TTeuber/AirMidi/docs/daw.md

# The desktop DAW (design, 2026-10-26)

The tracks page grows into a small DAW that does only MIDI: no audio, no plugins. It drives hardware synths and drum
machines (the box's synth, a drum machine over USB, Logic as one more destination). A linear arrangement comes first;
a clip launcher later, over the same clips (see "Later").

What it starts from (docs/desktop.md D3, D4): one transport, step tracks and clip tracks, events planned 120 ms ahead
and sent on time by the engine (`desktop/tracks/sequencer.dart`, `player.dart`), MIDI clock out, recording from any
input with MPE kept. Nothing is saved yet, so the model below replaces the current one without a migration.

## Two kinds of clip, two editors

The user's ask: MIDI clips and pattern clips. Double-clicking a MIDI clip opens a piano roll; double-clicking a
pattern clip opens a step sequencer.

- **MIDI clip:** notes in free time, recorded or drawn, with controller lanes. For synth parts, played lines,
  anything with feel. Edited in the **piano roll**.
- **Pattern clip:** a grid of rows (notes) by steps, the way a drum machine thinks. For beats, bass lines and
  arpeggios that are built step by step. Edited in the **sequencer**.

Any track can hold both kinds. The track says where the MIDI goes; the clip says what plays. A drum machine's track
can then have patterns for the groove and a recorded MIDI clip for a fill, and a synth's track can have a pattern
bass line under a played chorus.

A pattern clip can be turned into a MIDI clip ("to MIDI clip": the steps become notes, so they can get feel or a
fill). There is no way back: a free-time clip does not fit a grid without losing what made it free.

## The window

```
+-------------------------------------------------------------------------------------------+
| transport:  play stop rec  loop  | 120.0 bpm  4/4 | 3.2.1 | clock to: [drums] [box]       |
+----------------+--------------------------------------------------------------------------+
| track headers  | 1        2        3        4        5        6        7     (bars)       |
|                |   [=====loop range=====]                     |playhead                    |
| drums      M S | [pat A ][pat A ][pat B ][pat A ][fill~~]                                   |
|  TR-8 ch10   o | ^ pattern clips                     ^ a MIDI clip on the same track       |
| bass       M S | [pat 1 ................ ][pat 2 ......]                                    |
|  box synth ch1 |                                                                          |
| keys       M S |          [~~~~ take 1 ~~~~~~~~~~~~~~][~~~ take 2 ~~~]                      |
|  Logic ch3   o |                                                                          |
+----------------+--------------------------------------------------------------------------+
| bottom panel: the open clip's editor (piano roll or sequencer)  |  tabs: editor | device    |
|                                                                                           |
+-------------------------------------------------------------------------------------------+
```

- **Arrangement** at the top: tracks down, time across, a bar ruler, the loop range, the playhead. Zoom with
  pinch or cmd-scroll; positions snap to bars, beats or off.
- **Bottom panel**, as in Logic and Ableton: the clip being edited, in its editor. A drag on the divider sizes it.
  The **device** tab is the play view's synth controls (`SynthControls`) for the selected track's MIDI-CI device,
  so the sound can be changed next to the part.
- **Track header:** name and colour, the device (port, channel or MPE zone, the MIDI-CI device behind it if there
  is one), mute, solo, record arm with its input, and monitor (what is played goes through to the device while
  armed, as now).

### Clips on the arrangement

- Draw an empty clip (choose MIDI or pattern), or record one.
- Move, and copy with alt-drag or cmd-D (duplicate after itself). Split at the playhead, delete, copy and paste.
- The right edge sets the clip's length on the timeline. If that is longer than the content, the content loops (a
  one-bar pattern dragged to eight bars plays eight times); shorter cuts it. The left edge trims the start.
- A note still sounding where a clip ends gets its note off there, so cut clips never leave hanging notes.

## The piano roll (MIDI clips)

- Keys down the left with note names; on a drum device, the drum names from its map. Clicking a key plays it on the
  track's device.
- Notes as bars. Draw, select (click, drag a box, cmd-A), move, resize, delete. Alt-drag copies. Arrows move a
  semitone or a grid step; shift-arrows an octave or a bar.
- Grid and snap: 1/4 to 1/32 with triplets, or off. Quantize the selection (start, optionally ends, with a
  strength), transpose, legato, and set or scale velocity.
- **Velocity lane** under the notes: a stalk per note, dragged.
- **Controller lanes:** one per controller in the clip, added from a list. For a MIDI-CI device that list is its
  own controls by name ("Cutoff", "Env Amt", their ranges and named points from the control list) instead of CC
  numbers. Pitch bend, channel pressure, and program change get their own lanes. A lane is breakpoints: steps, or
  ramps that play as a stream of values.
- **MPE:** each note's own bend, pressure and timbre (CC74) are drawn along the note (bend as a line through the
  bar, as the clip painter does now) and can be edited by opening the note's expression.
- Recording into the open clip: overdub (adds, the default) or replace, over the loop range.

## The sequencer (pattern clips)

- Rows by steps. A click toggles a step. A drag up or down on a step sets its velocity, shown as the fill height.
- **Rows** come from a row set:
  - a drum map (General MIDI by default, or the device's own names);
  - a scale (key, scale and octaves, so a bass line only offers notes in key);
  - chromatic (an octave from a chosen note).

  Rows can be added, removed, muted and renamed.
- **Length** 1 to 64 steps, shown in pages of 16, and a step size (1/16 by default, 1/8, 1/32, triplets). Swing
  per pattern.
- **Per step:** velocity, gate (length), probability, nudge (a little early or late), and repeat (ratchets: 2 to 4
  hits in the step). The lane under the grid edits the chosen one for every step in a row, like the piano roll's
  velocity lane.
- **Per row length (later):** rows of different lengths drift against each other, the polymeter the step tracks
  have now per track.
- **Parameter locks:** a step can also set a control of the device (the filter opens on step 7 only).
  MIDI-CI names make these readable. It is what makes a step sequencer play a hardware synth well. A lock lasts one
  step: the steps without one send the track's own value (its synth's saved setting, or the list's default).

### Every clip is its own

Every clip, pattern or MIDI, owns its content (user decision 2026-10-26). Duplicating a clip copies it, and a copy
can go to another track (drag it onto that track, or copy and paste), so a drum pattern can be tried on a second
drum machine. Editing one clip never changes another.

## Model

Pure Dart, no Flutter imports, tested like `sequencer.dart` now.

```
Project
  tempo (bpm; tempo changes later), time signature (one; changes later), loop range (times in beats)
  tracks: [Track]
Track
  name, colour, mute, solo
  device: port name, channel (0-15) or MPE zone (manager channel + member count), MIDI-CI device id (optional)
  input (for recording), arm, monitor
  clips: [Clip]                       placements on the timeline
Clip
  start, length (beats on the timeline), offset (where in the content it starts), loops: bool
  content: MidiContent | Pattern      owned by the clip; a copy copies it
MidiContent
  length (beats, the loop length), notes: [Note], lanes: {controller: [Point]}, other: [raw events]
Note
  start, length, pitch, velocity, release velocity, expression: {bend|pressure|timbre: [Point]} (MPE)
Pattern
  rows: [Row(note, name, mute)], steps, step size, swing, cells[row][step]: Step(velocity, gate, prob, nudge, repeat)
```

- **Times** in beats (doubles) everywhere, as now: no ppq rounding inside, so recorded timing is kept exactly. SMF
  export rounds to its ppq.
- **Values** are stored at MIDI 2.0 resolution (16-bit velocity, 32-bit controllers; the MIDI-CI controls already
  are 32-bit) and scaled down for MIDI 1.0 ports. The model does not have to change when MIDI 2.0 ports arrive.
- **Recording turns raw messages into notes and lanes.** That is a change from the current clips, which keep the
  raw bytes. It is needed for editing: a note has to be one thing that moves with its own bend. Messages that are
  neither notes nor controllers (SysEx, for instance) stay raw in `other`.
- **MPE without fixed channels.** An MPE recording stores notes with their expression, not the member channel each
  was played on. Playback hands out member channels afresh (least recently used, as the strips' player does). Copied
  or moved notes then never collide on a channel. On a track that is not MPE, notes go out on the track's channel
  and per-note bends are dropped (with a warning on the track).
- **Undo:** every edit is a command (do / undo) on the project. One stack per project, cmd-Z / shift-cmd-Z. A drag
  is one command, not one per frame.

## Playback

The arrangement compiles into events window by window, as `eventsBetween` does now. Every 20 ms, for the next
120 ms, each track asks the clips that overlap the window for their events (notes cut at the clip's end, pattern
steps with swing, nudge and probability), plus clock.

- **Edits during play** take effect from the next window: at most 120 ms of already planned events play the old
  way. This is simpler and safer than pulling back events already handed to the engine, which risks lost note offs.
- **Probability** is rolled when a window is planned, with a seed per pass, so a loop does not repeat the same
  "random" choices every time unless that is asked for.
- **Starting in the middle:** the last value of each controller before the start position is sent first
  (controller chase, on by default). This matters for hardware: the filter is where the song says, not where it was
  left. Notes that began before the start are not started (note chase off, as in most DAWs; an option later).
- **Clock** out per port as now; follow Logic later (docs/desktop.md D5).
- **Latency offset per port** (ms, positive or negative): a synth over BLE and a drum machine over USB answer at
  different delays, so each port's events move by its offset. Kept for the computer, not the song (the same synth
  answers as late in every project). Set by hand for now; a calibration tool with a loopback later.

## Recording

- Arm a track (or several), press record. Each armed track gets a new MIDI clip from where recording started to
  where it stopped, from its input, at the engine's timestamps, as now.
- **Loop recording:** each pass adds to the clip (overdub), as now. Takes (each pass its own clip, pick the best)
  come later.
- **Count-in** of a bar, and an optional **MIDI click**: a note on a chosen port and channel (a drum machine's rim
  shot), since there is no audio for a metronome.
- **Input latency:** the input's own offset (BLE input arrives a few ms late) is taken off the timestamps.
- Recording into a pattern (step entry while stopped, or live into the steps it lands nearest) comes after the
  sequencer itself.

## Projects and files

- One project is one JSON file (`.airmidi`, readable, with a format version), saved where the user picks
  (the default is `~/Music/airmidi`). Autosave and a recent-projects list. The sandbox needs the
  user-selected-files entitlement.
- **Standard MIDI File** export: type 1, a track per track, patterns rendered to notes. Import: each SMF track
  becomes a track with one MIDI clip.
- **Device state with the project:** a MIDI-CI device reports its current values (the MIDI Message Report
  the synth page already asks for). The project keeps them per track and sends them back when it opens and when
  play starts, so the box's synth sounds the same next time. For other hardware: program change and bank select
  per track, sent the same way, first.

## Phases

- **A1, the arrangement:** the model above, tracks with headers, clips of both kinds placed, moved, resized
  (looping), duplicated, split, deleted, zoom, snap, loop range, playhead, undo. The current step tracks and clip
  tracks become a pattern clip and a MIDI clip. Plays through the existing scheduler.
- **A2, the piano roll:** notes, the velocity lane, snap, quantize, transpose, audition, recording into the clip
  (raw recordings turned into notes, MPE included).
- **A3, the sequencer:** the grid, row sets, length and step size, swing, the per-step lane (velocity, gate,
  probability, nudge, repeat), "to MIDI clip".
- **A4, files:** save, open, autosave, recent projects, SMF export and import.
- **A5, controllers:** controller lanes with MIDI-CI names, MPE expression editing, controller chase, the device
  tab.
- **A6, hardware:** program change per track, device state with the project, MIDI click and count-in, latency
  offsets per port, parameter locks.
- **Later:** the clip launcher (a grid of the same clips by scene; the clips' contents are already separate from
  where they sit on the timeline), tempo and time signature changes, takes, track automation over the whole song,
  follow Logic, MIDI 2.0 ports, row lengths per pattern row, mono 303-style patterns (a note, slide and accent per
  step).

Tests as now: the model and the compiler in Dart unit tests (windows join without gaps or doubles, clip ends cut
notes, loops, swing, chase, undo), timing through a mido port, the pages driven with `tool/drive.py`.

## Status

- **A1 (2026-10-26):** `app/lib/desktop/daw/`. `model.dart` (the model above; MIDI 2.0 values with M2-115
  scaling), `compile.dart` (clips to timed events: passes through looping content, notes cut at the clip's end and
  at each pass, the loop's end; patterns with swing, nudge, repeats and probability rolled from the step's identity;
  MPE notes on member channels handed out afresh, each starting from its own bend), `record.dart` (takes: raw input
  rebuilt into notes and lanes every tick, overdub in the loop range or a clip that grows by bars; MPE kept per note,
  detected at three note channels), `history.dart` (undo by snapshot), `player.dart` (the scheduler of D3 over a
  continuous beat count mapped into the loop; clock follows the continuous count; Song Position and Start or
  Continue), `arrange_page.dart` + `timeline.dart` (transport, headers with port, channel, MPE, input, M/S/R;
  ruler: click = start marker, drag = loop range; clips: move across tracks, resize both edges, alt-drag copy,
  right-click menu with rename, duplicate, split, copy, delete; empty space: new MIDI or pattern clip, paste;
  zoom and scroll by trackpad or cmd-scroll; keys: space, R, L, cmd-Z, delete, cmd-D/C/V/T), the bottom panel
  (`pattern_editor.dart`: toggle steps, length, step size, swing, row sets; `piano_roll.dart`: shows the notes and
  each note's bend). Tracks can send to "airmidi app" (to Logic) and record from it. Tests (`test/daw_test.dart`):
  value scaling, clip passes and offsets, windows joining for 20 random splits, swing, repeats, probability,
  MPE channels and bends, solo, the loop cut, takes in a loop, growing takes, an MPE take, undo. Tried in the app
  through mido ports at 120 bpm: a beat and its duplicate with snares added only to the copy (every note on time to
  0.2 ms, the original unchanged), a one-bar loop repeating without a gap, a two-note take recorded from "airmidi
  app" (passed through while recording, then played back exactly 2000 ms later each pass), undo and redo of the
  take, moving it a bar and onto another track, clock (20.83 ms ticks, Start, Stop), split at the start marker.
  The old step and clip tracks (`desktop/tracks*`) are gone. Not tried: alt-drag (the drive hook cannot hold alt).

- **A2 (2026-10-27):** the piano roll edits (`piano_roll.dart`, the edits as functions in `roll_edit.dart`). Draw
  (double-click, or click in draw mode, B; a drag sets the length), select (click, shift-click, box, cmd-A, Esc),
  move (snapped, pitch by row, the group kept inside 0..127 and after beat 0), alt-drag copies, resize the end or the
  start, delete (double-click or right-click a note, delete key); arrows move a semitone or a grid step (shift: an
  octave or a bar); cmd-C / V (at the start marker inside the clip) / D (after itself); grids 1/4 to 1/32, 1/8T,
  1/16T, off; quantize (Q, strength 25-100 %, ends optional; lengths kept otherwise), legato (chords stay chords),
  transpose and octave, velocity up and down, all on the selection or every note when none is selected; the velocity
  lane (drag a stalk, a selected group moves together, or sweep across). Keys down the left are a keyboard (drum
  names on a channel 10 track); clicking one plays it on the track's device, and so does a note being drawn, moved
  or transposed. Keys go to the roll after a click in the bottom panel (its delete removes notes, not the clip).
  Recording: overdub or replace (the take in the loop range starts from an empty clip; undo brings the old notes
  back). Tests (`test/roll_test.dart`): the edit functions, replace, and the widget driven by the mouse (draw, move,
  delete, resize, box select, the velocity lane on a group). Tried in the app through the IAC bus: four notes drawn
  played back exactly on their beats and sixteenths; box select, cmd-A, the up arrow, cmd-Z, backspace, a lowered
  velocity (21 out), a key click auditioned, alt-drag copied a note a beat and a half later. The drive tool gained
  `drag`, `rtap` (right click) and the keys space, backspace, escape, the arrows and meta / shift / alt.

- **A3 (2026-10-27):** the sequencer (`pattern_editor.dart`, one canvas for the grid and labels, one for the lane).
  A click adds a step and plays it, a drag paints along (every cell between two pointer events, so a fast drag
  skips none); a click on a step removes it, up/down sets its velocity (the fill's height), sideways erases along.
  The lane under the grid edits the selected row's velocity, gate (0.05-2 steps), probability, nudge (+-half a
  step) or repeat (1-4), by dragging or sweeping, double-click for the default; steps show their chance (a dot),
  repeats (ticks) and nudge (a mark). Rows: GM 6 or 12 rows, or a scale (key, eight scales including chromatic, from
  an octave, one or two octaves); + row (the GM drums not there yet, or a semitone above); a label's M mutes, a
  click selects it for the lane, a right-click renames, moves the note, moves or removes the row. Length 1-64 with
  "double" (the second half a copy), step sizes 1/8, 1/16, 1/32, 1/8T, 1/16T, swing, shift (rotate) left/right, pages
  of 16 when the steps are too narrow, following the playhead. "to MIDI clip" (panel and clip menu):
  `patternHits` is now what both playback and the conversion read, so the MIDI clip plays exactly what the pattern's
  first pass played (probabilities rolled the same; a step nudged before the start wraps to the end). The piano roll
  opens centred on the clip's notes and has a wider key column with drum names on a channel 10 track. Tests
  (`test/pattern_test.dart`): conversion = playback, the wrap, scales, rotate, double, the widget (add and audition,
  a fast paint, sideways erase, remove, undo, velocity by drag, the lane, pages). Tried in the app through mido: a
  beat of kick, snare and painted hats with a velocity sweep (112 down to 10 out) and a 4x repeat (31.25 ms apart),
  then "to MIDI clip": the bar's 50 events identical before and after.

- **A4 (2026-10-27):** files. `project_file.dart`: one JSON file per project (`.airmidi`, "format": "airmidi
  project", version 1; values as kept, step settings only where they differ from the defaults; clip ids kept, so
  probabilities roll the same after reopening; a newer or foreign file is refused). `store.dart`: the project is
  written again every 3 s when it changed (atomically, through a temporary file), so there is no save to forget; an
  untitled project goes to an autosave file in the app's folder; the last project opens again at start; up to 8
  recent ones. `smf.dart`: export type 1 at 480 ticks a beat through the same compiler that plays, so a file holds
  what play sends (patterns rendered, MPE on member channels after an MPE Configuration Message); import type 0/1
  (running status, SysEx skipped, SMPTE refused), a track per channel, or one MPE track when the file sends an MPE
  setup or plays notes on three channels or more (the setup is not kept: played again at a clip's start it would cut
  the synth's notes); one clip per track in whole bars; an empty project takes the file's tempo. The arrangement's
  "file" menu: new, open, recent, save as, import, export; cmd-S writes now, shift-cmd-S saves as, cmd-O opens.
  macOS: file_selector (the Flutter team's, BSD) for the dialogs, the user-selected files and music folder
  entitlements; ~/Music/airmidi is the default folder (the sandbox's Music is the user's own). Recent projects
  outside ~/Music cannot be reopened without the dialog (no security-scoped bookmarks yet). Tests
  (`test/files_test.dart`): a song with one of everything reads back to the same file and the same MIDI, refusals,
  the export's header, tempo and MPE setup, export then import plays the same ticks, a hand-made type 0 file with
  running status, the store (autosave, save as, reopen at start, recent). Tried in the app: a beat autosaved to the
  container, the app restarted with the beat back, ~/Music/airmidi made, the save dialog opening there. Not tried in
  the app: picking a file in the open or save dialogs (the terminal cannot click in them).

- **A5 (2026-10-27):** controllers. A track can hold its synth's MIDI-CI control list (`devices.dart`; the track
  header's menu, "synth controls from ...": a box the desktop has found, over Wi-Fi or BLE, `/api/ci/device`, or a
  JSON file; saved with the project). The piano roll's lane row (`lanes.dart`): velocity, the clip's controller lanes
  named by the synth ("Cutoff" for CC 74, its readings in Hz or ms while dragging) or by General MIDI, "+ lane" (the
  synth's controls first, then common ones it does not name, any CC, bend, pressure, program), and on an MPE track
  the selected note's own bend, pressure and timbre (points from the note's start). Points: click adds, drag moves,
  double-click makes it ramp to the next, right-click removes, draw mode draws along a drag; a ramp plays as a
  stream (a value every 1/64 beat at most, only when the message changes; `laneValues`, the same however the windows
  fall). Controller chase (`chase` in compile.dart, the transport's "chase", on by default): the last value of every
  controller, bend, pressure and program before the start goes out just before the first beat, and again where the
  loop starts over; MPE notes' own expression is not chased. The bottom panel's "device" tab: the play view's
  SynthControls for the selected track's list, sending through the track's port and following the input of the
  same name (not the app's own port, whose other side is the app itself). Tests: ramps (stream, windows), chase,
  the lane editor (add, drag, ramp, remove), an MPE note's bend edited and played on its channel, lists and ramps
  saved. Tried in the app with the box on Wi-Fi and daisy_synth on its TRS: the list fetched ("Daisy Poly Synth, 19
  controls"), the device tab with daisy's envelopes and XY pad, a Vibrato drag sending CC 1 rising 4 to 49, the "+
  lane" menu with daisy's names, a Cutoff ramp 12 to 115 over two beats (a value every 7-16 ms) restarting with the
  loop, the chase sending Cutoff 115 before a start at beat 4 (and nothing with chase off). Not tried: the last hop
  to daisy through the box from the DAW (it needs the box as a CoreMIDI port: its network session connected in
  Audio MIDI Setup, or BLE MIDI); the box's own "current values" report is not asked (values start at the list's
  defaults; device state is A6). Fixed on the way: menu chips ("rows", "+ row", "+ lane") never opened their menus
  (an inner tap detector won the gesture).

- **A6 (2026-10-27):** hardware. Program change and bank select per track (the header's menu, "program and bank":
  program 1-128, MSB, LSB, blank fields not sent). The synth's settings with the project (`Track.state`, lane keys
  at 32 bit): what the device tab sets and what the synth's knobs send back is kept on the track, and "read from the
  synth" asks the box for a MIDI Message Report (the box the list came from, or another; the synth's answer comes
  over the box's own link, its Wi-Fi web socket or BLE MIDI) and keeps every value. Bank, program and settings go
  out when a project opens (and the app starts with it), when play starts (before the chase, so the song's lanes win)
  and on "send to the synth"; MIDI file export writes them at the start of each track. They are not undone (they are
  where the knobs are): after undo the synths' values go back onto the restored tracks. The click (transport:
  a port, note and channel, General MIDI side stick on channel 10 by default, the bar's first beat louder) and the
  count-in (off, 1 or 2 bars, when recording from stopped; the click plays in it even when off; the position shows
  "count n"). Latency per port (transport, "latency": outputs and inputs, -100 to 100 ms, kept in the app's
  settings): an output's events go out that much early (the lookahead and the start grow by the largest), an input's
  timestamps are taken back by it. Parameter locks in the sequencer ("+ lock": the synth's controls first, then
  the common ones; a step's bar is its lock, double-click or right-click takes it off; the line across the lane is
  the track's own value, and a step with locks has a mark in its corner): every group of steps that play together
  sends each locked controller, the first locked step's value (by row) or the own value, so a lock lasts one step
  and a step that does not play leaves nothing behind; with no own value a lock lasts to the next. "to MIDI clip"
  turns the locks into lane points that play the same. Tests (`test/hardware_test.dart`, `pattern_test.dart`): the
  setup's order and channels, locks (one step, the locked step winning at the same time, no own value, the list's
  default, windows joining, to MIDI clip, chase), files, export, the player with a fake engine (count-in with the
  click, the click on, an output's offset), the lock lane driven by the mouse. Tried in the app with the box on its
  RTP session and daisy_synth on its TRS: program 5 / bank 1, 2 sent on play (CC 0, CC 32, program 4); the count-in
  bar of four clicks 545.4 ms apart at 110 bpm, the first louder, then the song's; daisy's cutoff set to CC 74 = 100
  from outside the app and read back through the box ("19 values read from the synth (ok)", cutoff 4.7 kHz), all
  19 kept in the project; "send to the synth" 22 messages into the box's RTP port and out of its TRS; a pattern with
  step 9's cutoff locked at 110 Hz playing CC 74 = 32 before that step and 100 (the own value) before the others,
  to the IAC bus and through the box to daisy (36 messages in, 88 bytes out on TRS); an IAC offset of +20 ms moving
  its notes 19.9 ms ahead of the click on another port; a Vibrato drag kept as the track's setting. Not tried: BLE
  for "read from the synth", input offsets (no loopback in this setup), program changes heard on a synth that has
  programs (daisy has none). Seen on the way: something else on this Mac (not the DAW: a plain script does the same)
  repeats bank select on the IAC bus. The drive tool gained digits and `text` (a text field's text, through a new
  debug hook command).

## Decided (2026-10-26, the user)

1. Every clip is its own (no shared patterns); clips copy to other tracks.
2. Both clip kinds on any track.
3. The editor in the bottom panel.
4. MPE replayed on fresh member channels.
5. Parameter locks later (they came in A6).
