TTeuber/AirMidi/hardware/pcb/board_3d_bottom.png

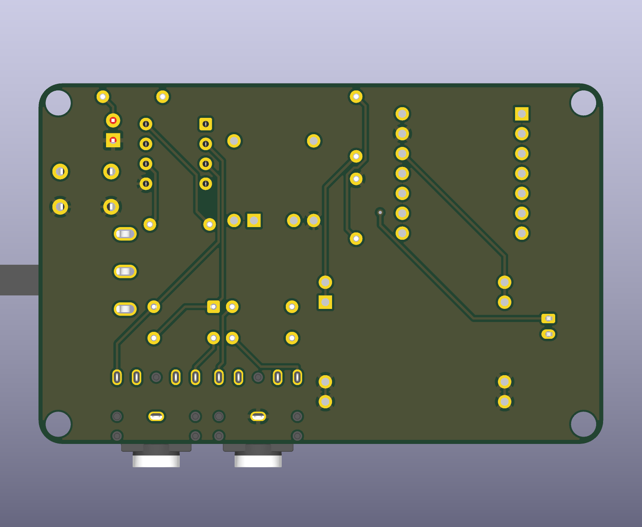
hardware/pcb/board_3d_bottom.png
