TTeuber/AirMidi/hardware/enclosure/base.step

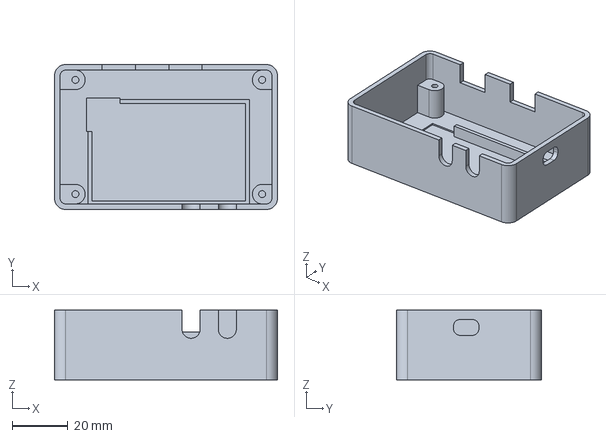
[picture p13: CAD file, 2026-10-10]
hardware/enclosure/base.step
80.0 x 52.0 x 25.1 mm
