TTeuber/AirMidi/hardware/enclosure/lid.step

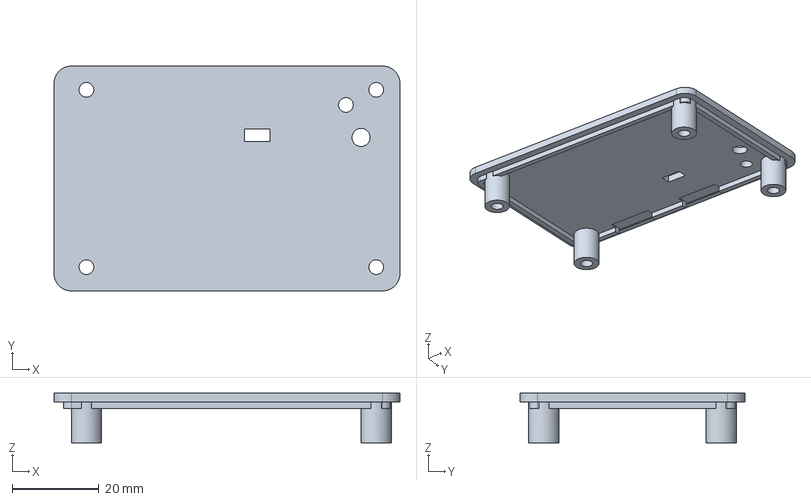
[picture p14: CAD file, 2026-10-10]
hardware/enclosure/lid.step
80.0 x 52.0 x 11.5 mm
