TTeuber/AirMidi/(list of files, cad)

Other CAD files:
hardware/enclosure/base.stl
hardware/enclosure/lid.stl
