TTeuber/AirMidi/hardware/enclosure/assembly_views.png

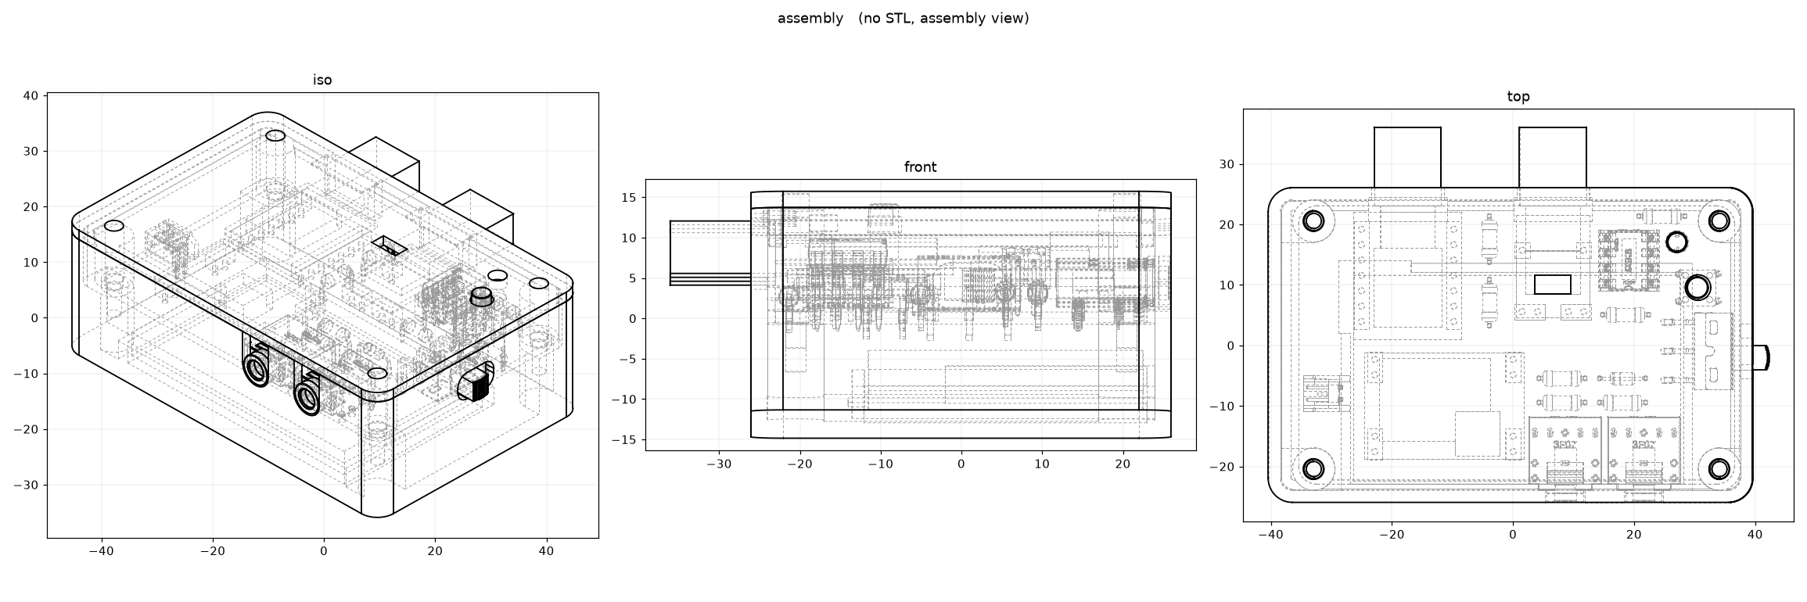
hardware/enclosure/assembly_views.png
