TTeuber/AirMidi/hardware/pcb/schematic.pdf

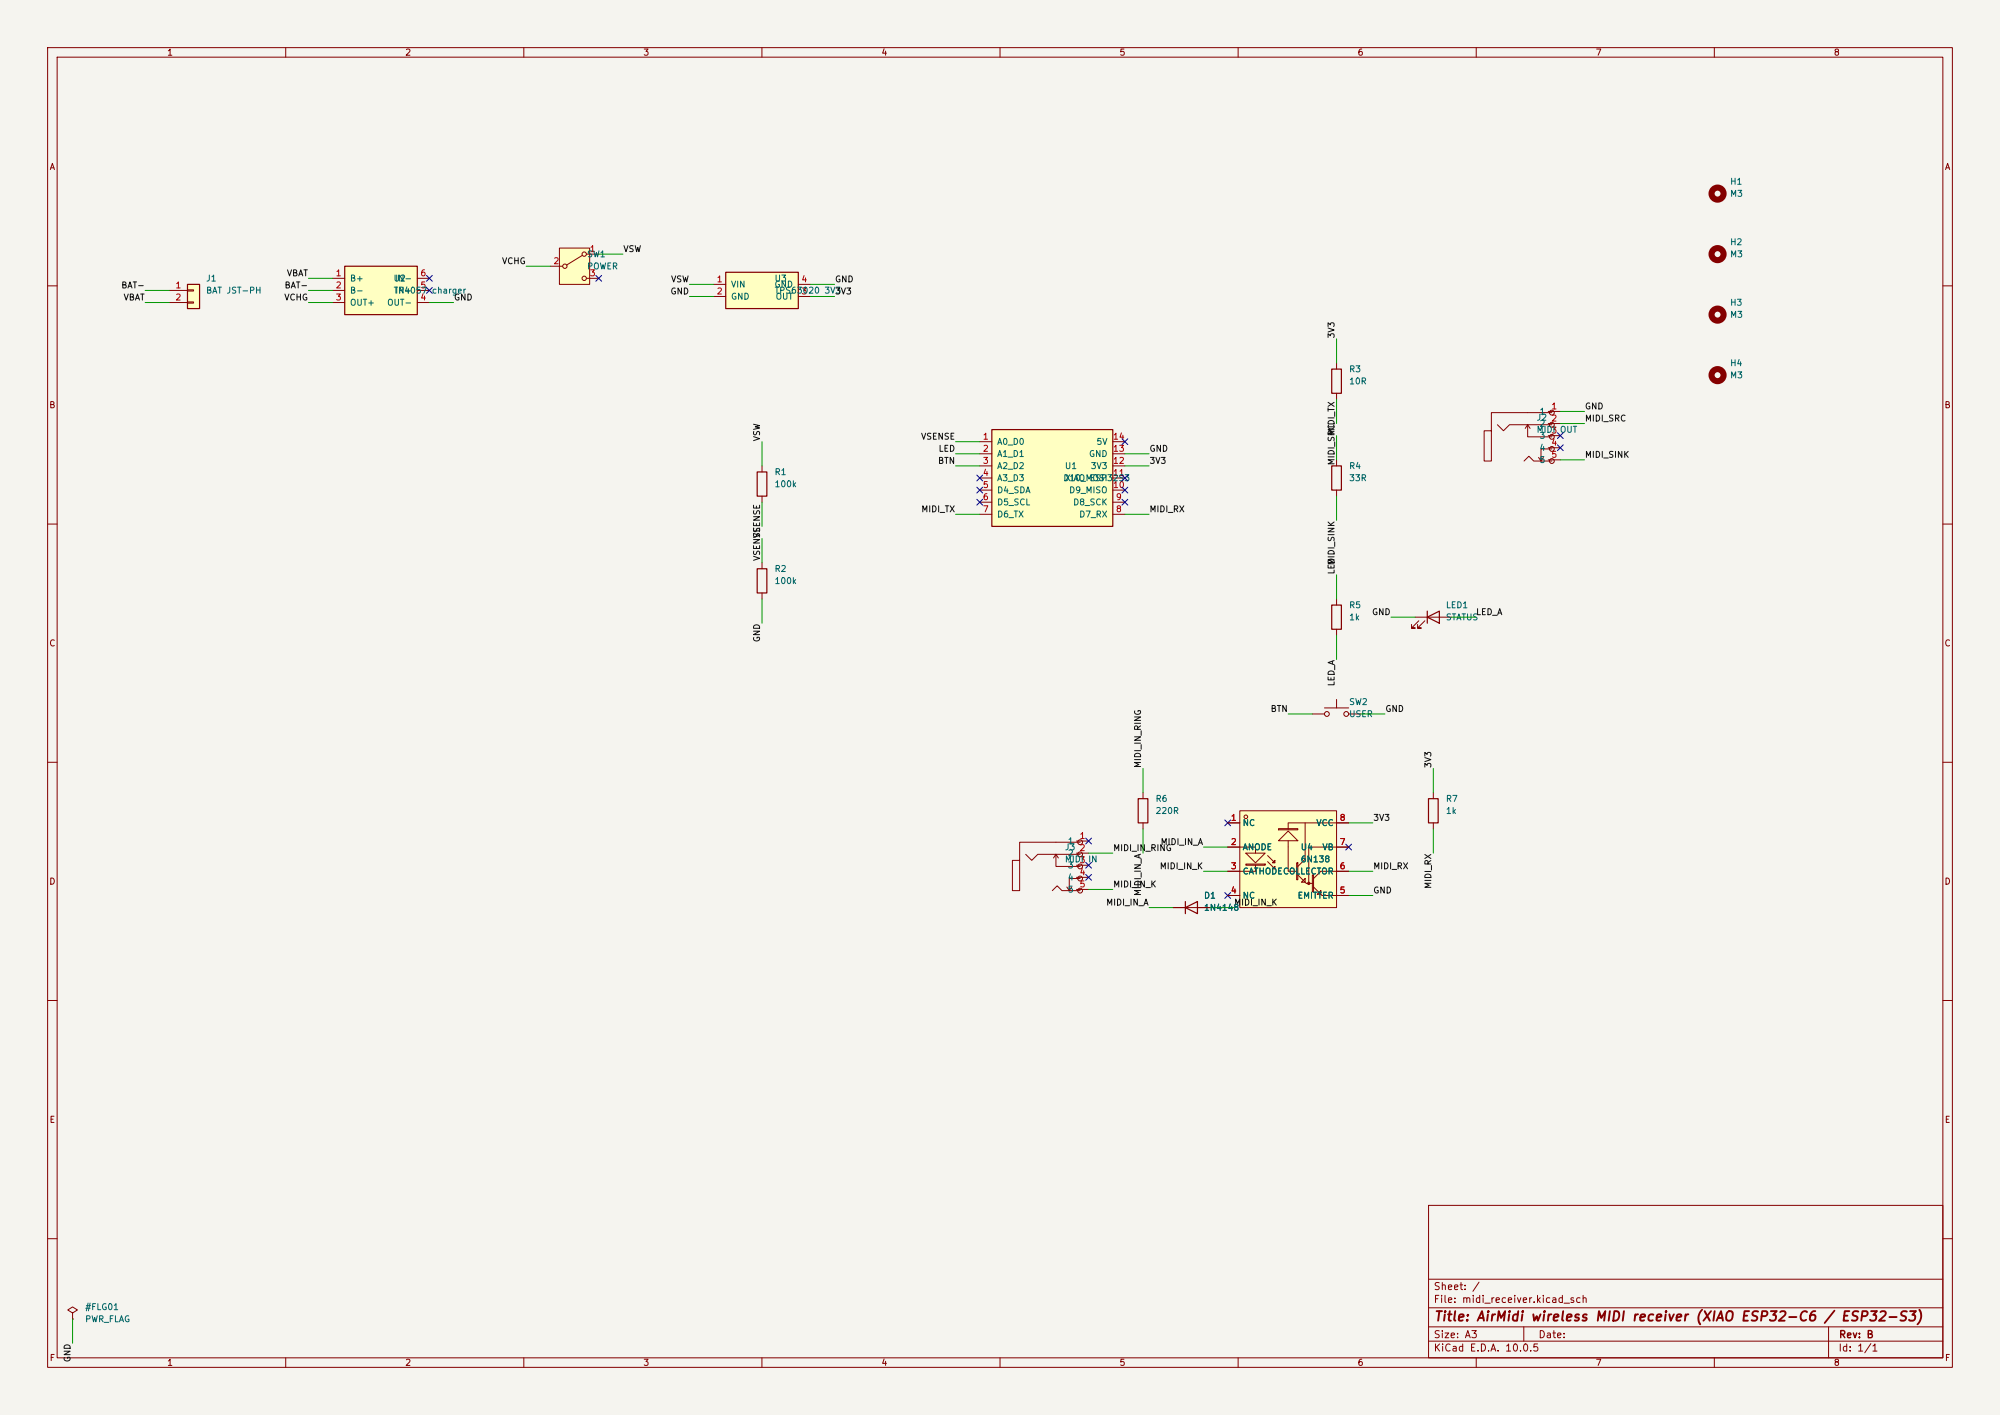
[picture p16: page 1]

Sheet: /
File: midi_receiver.kicad_sch
Title: AirMidi wireless MIDI receiver (XIAO ESP32-C6 / ESP32-S3)

Size: A3 | Rev: B | F Date:
KiCad E.D.A. 10.0.5 | Id: 1/1
