TTeuber/AirMidi/hardware/pcb/board.pdf

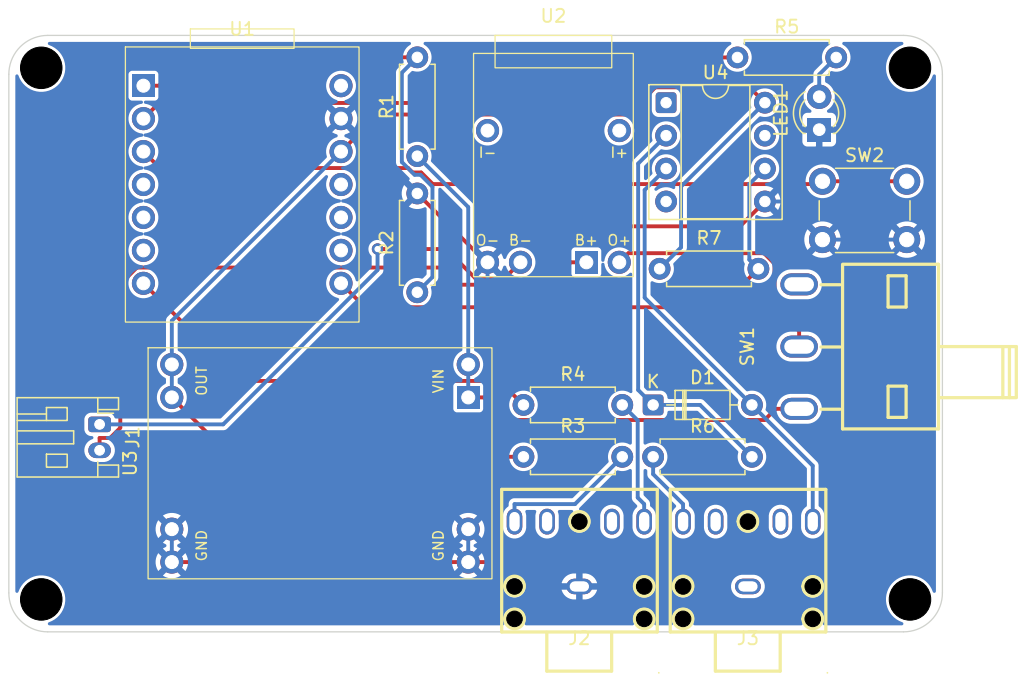
[picture p17: page 1]
