TTeuber/AirMidi/hardware/pcb/kicad/midi_receiver.kicad_pcb

## KiCad design hardware/pcb/kicad/midi_receiver.kicad_pcb (2026-10-10)

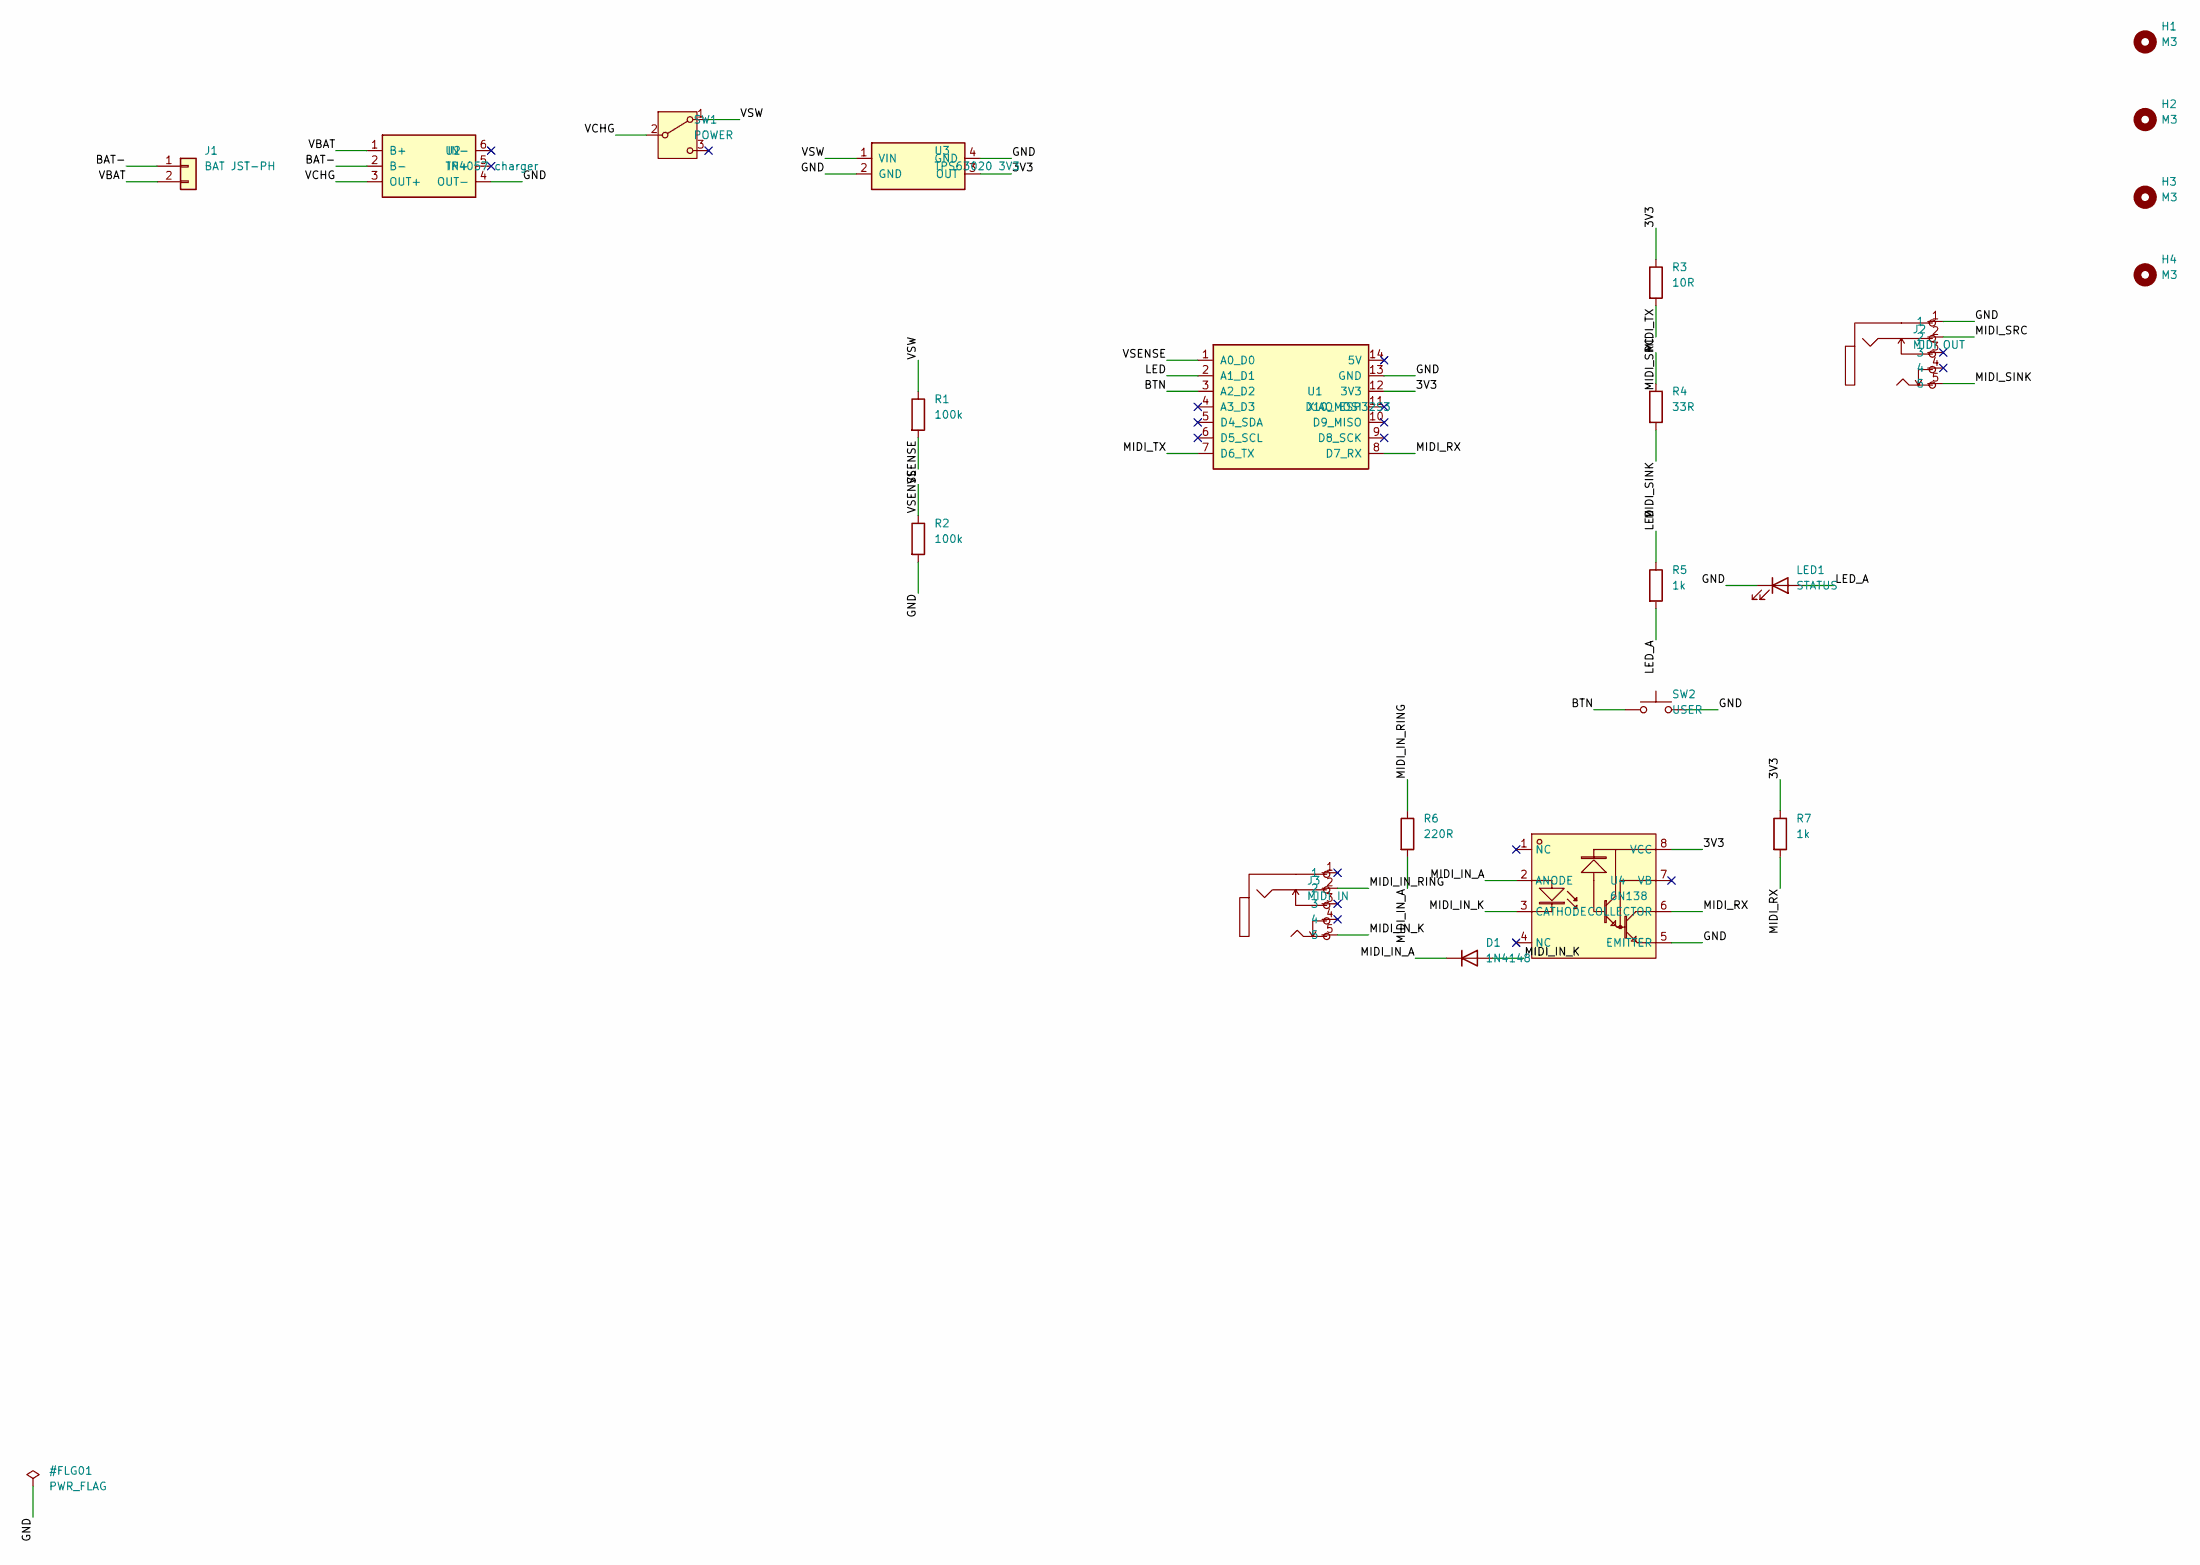
[picture p18: schematic midi_receiver.kicad_sch, AirMidi wireless MIDI receiver (XIAO ESP32-C6 / ESP32-S3)]

Parts:
D1: 1N4148; D_DO-35_SOD27_P7.62mm_Horizontal
H1, H2, H3, H4: M3; MountingHole_3.2mm_M3
J1: BAT JST-PH; JST_PH_S2B-PH-K_1x02_P2.00mm_Horizontal
J2: MIDI OUT; AUDIO-TH_PJ307C
J3: MIDI IN; AUDIO-TH_PJ307C
LED1: STATUS; LED_D3.0mm
R1, R2: 100k; R_Axial_DIN0207_L6.3mm_D2.5mm_P7.62mm_Horizontal
R3: 10R; R_Axial_DIN0207_L6.3mm_D2.5mm_P7.62mm_Horizontal
R4: 33R; R_Axial_DIN0207_L6.3mm_D2.5mm_P7.62mm_Horizontal
R5, R7: 1k; R_Axial_DIN0207_L6.3mm_D2.5mm_P7.62mm_Horizontal
R6: 220R; R_Axial_DIN0207_L6.3mm_D2.5mm_P7.62mm_Horizontal
SW1: POWER; SW-TH_3P-P4.80_HX-SS12D10G6-WJ
SW2: USER; SW_PUSH_6mm_H13mm
U1: XIAO ESP32S3; XIAO_ESP32S3
U2: TP4057 charger; TP4057_Module
U3: TPS63020 3V3; TPS63020_Module
U4: 6N138; DIP-8_W7.62mm_Socket

Connections:
/3V3: R3.1, R7.1, U1.12 (3V3), U3.3 (OUT), U4.8 (VCC)
/BAT-: J1.1, U2.2 (B-)
/BTN: SW2.1, U1.3 (A2_D2)
/GND: J2.1, LED1.1 (K), R2.2, SW2.2, U1.13 (GND), U2.4 (OUT-), U3.2 (GND), U3.4 (GND), U4.5 (EMITTER)
/LED: R5.1, U1.2 (A1_D1)
/LED_A: LED1.2 (A), R5.2
/MIDI_IN_A: D1.1 (K), R6.2, U4.2 (ANODE)
/MIDI_IN_K: D1.2 (A), J3.5, U4.3 (CATHODE)
/MIDI_IN_RING: J3.2, R6.1
/MIDI_RX: R7.2, U1.8 (D7_RX), U4.6 (COLLECTOR)
/MIDI_SINK: J2.5, R4.2
/MIDI_SRC: J2.2, R3.2
/MIDI_TX: R4.1, U1.7 (D6_TX)
/VBAT: J1.2, U2.1 (B+)
/VCHG: SW1.2 (B), U2.3 (OUT+)
/VSENSE: R1.2, R2.1, U1.1 (A0_D0)
/VSW: R1.1, SW1.1 (A), U3.1 (VIN)

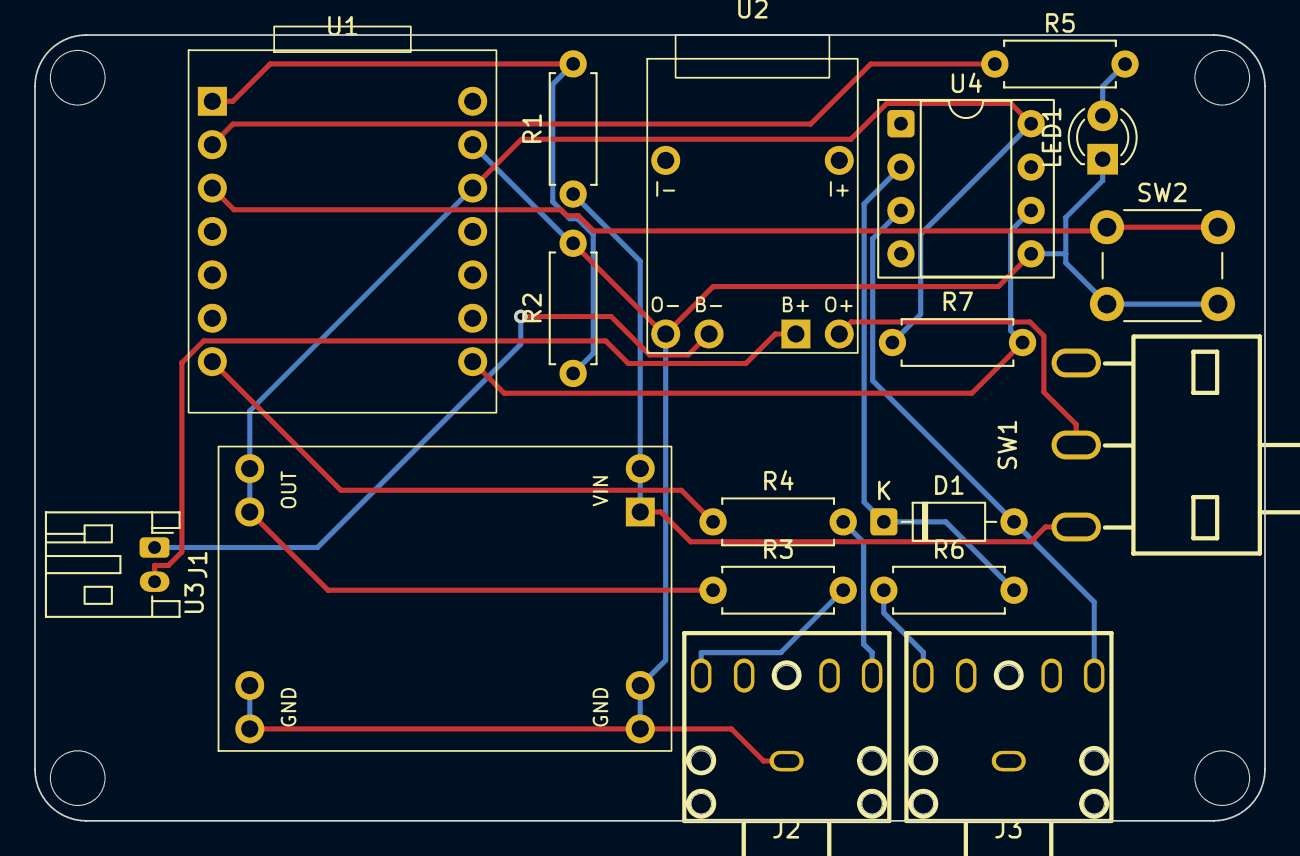
[picture p19: board midi_receiver.kicad_pcb from above]

Board: 2 copper layers, 72.0 x 46.0 mm, 22 parts (0 on the bottom side), 17 nets.
