TTeuber/AirMidi/app/packages/midi_engine/src/engine.h

// The desktop MIDI engine (docs/desktop.md): the computer's MIDI ports through libremidi, for Dart over dart:ffi.
// What Dart cannot do on time is done here:
//   - input: every message is stamped with the monotonic clock (ame_now_ns) as it arrives and queued; Dart reads
//     the queue whenever it gets to it (ame_read) after a wake-up call;
//   - output: Dart hands over messages with the time they are due (ame_send); a thread of ours sends each one then.
// Plain MIDI 1.0 bytes both ways. Thread-safe: every function may be called from any thread.
#pragma once
#include <stdint.h>

#if defined(_WIN32)
#define AME_API __declspec(dllexport)
#else
#define AME_API __attribute__((visibility("default")))
#endif

#ifdef __cplusplus
extern "C" {
#endif

// Starts the engine (the send thread, the port observer). wake is called from any thread when something is waiting
// for ame_read: input, or the port list changed. It is called again only after ame_read has emptied the queue.
// Returns 0, or -1 if no MIDI system is available.
AME_API int ame_start(void (*wake)(void));
AME_API void ame_stop(void);

// The monotonic clock every timestamp uses, in ns.
AME_API int64_t ame_now_ns(void);

// The port lists, as of the last ame_refresh (call it after a "ports" event). out: 0 = inputs (we receive), 1 =
// outputs (we send). Strings stay valid until the next ame_refresh.
AME_API int ame_refresh(void);
AME_API int ame_port_count(int out);
AME_API const char *ame_port_name(int out, int i);
AME_API int ame_port_type(int out,
                          int i);  // libremidi transport_type bits: 2 software, 8 hw, 16 usb, 32 ble, 128 network

// Opens port i of the last refresh, or a virtual port others see under name (an input others send to, or an
// output others receive from). Returns a handle > 0, or -1.
AME_API int ame_open(int out, int i);
AME_API int ame_open_virtual(int out, const char *name);
AME_API void ame_close(int handle);

// Queues n bytes (one or more whole messages) for an output, due at at_ns (ame_now_ns time; 0 or the past = now).
// Messages due at the same time go out in the order they were queued. Returns 0, or -1 for a bad handle.
AME_API int ame_send(int handle, const uint8_t *bytes, int n, int64_t at_ns);

// Drops everything still queued for an output (a sequencer stopping); returns how many messages were dropped.
AME_API int ame_clear(int handle);

// Routes (the router page): what arrives on input in_handle goes straight out to out_handle, from the input's own
// thread, if it passes: channel messages on a channel in mask (bit c = channel c, 0-based) moved to map[c], notes
// and poly pressure in lo..hi transposed by transpose (dropped if that leaves 0..127), and only the message types in
// types (AME_T_* bits). Dart still gets every message. id: the caller's; setting an id again replaces that route.
#define AME_T_NOTES 1u  // note on/off, poly pressure
#define AME_T_CC 2u     // control change (and channel mode)
#define AME_T_PROGRAM 4u
#define AME_T_PRESSURE 8u  // channel pressure
#define AME_T_BEND 16u
#define AME_T_SYSEX 32u
#define AME_T_CLOCK 64u   // clock, start, continue, stop, song position
#define AME_T_OTHER 128u  // other system common and real-time (active sensing, reset, MTC, tune request)
AME_API int ame_route_set(int id, int in_handle, int out_handle, uint16_t mask, const uint8_t *map, int transpose,
                          int lo, int hi, uint32_t types);
AME_API void ame_route_remove(int id);
// How many messages a route passed so far (for the page's activity lights), -1 for no such route.
AME_API int64_t ame_route_count(int id);

// Takes the oldest waiting event: kind 1 = MIDI (handle, bytes, *t_ns its arrival time), kind 2 = the port list
// changed. Returns the kind (0 = nothing waiting); *n is the message length, cut to cap if longer.
AME_API int ame_read(int *handle, uint8_t *bytes, int cap, int *n, int64_t *t_ns);

// For the timing test: how late the send thread was, over all messages sent so far (ns).
AME_API int64_t ame_late_max_ns(void);
AME_API int64_t ame_late_sum_ns(void);
AME_API int64_t ame_sent(void);

#ifdef __cplusplus
}
#endif
