TTeuber/AirMidi/(commit log)

2026-10-06 Plan: scope, architecture, test rig and order of work
    Written before any code so the history starts with the design: purpose,
    transports (TRS, BLE MIDI, Network MIDI 2.0 / RTP-MIDI, ESP-NOW, USB on
    the S3), UMP as the internal format, MIDI-CI over TRS for device
    discovery, signed OTA with rollback, the Daisy Pod test rig, and spikes
    S0-S3 before phase 1.
2026-10-07 Plan: AudioFuse Studio as the test rig instead of the Daisy Pod
    Both ends of every test sit on the Mac (BLE/Wi-Fi to the receiver, USB
    MIDI from the AudioFuse), so latency is measured one way on one clock.
    The AudioFuse is TRS Type B, the receiver Type A: crossover cables
    needed. MIDI-CI device side becomes a Mac stand-in on the AudioFuse
    ports; the Pod stays an optional demo device. Both missing specs
    (M2-117, M2-124) are now downloaded.
2026-10-07 Spike S0: TRS echo firmware + Mac round-trip test, passed
    The receiver echoes J3 IN to J2 OUT byte for byte; mac_test.py sends
    through the AudioFuse and checks every message comes back unchanged and
    in order, reading the receiver console to tell which cable fails.
    First run showed 13-600 ms round trips: uart_read_bytes() blocked for its
    whole timeout waiting for 256 bytes. Reading one byte, then whatever is
    buffered, brought it to 3.0 ms (1.9 ms of that is wire time).
2026-10-08 Spike S3: MIDI-CI initiator over TRS, Mac responder, passed
    The receiver sends Discovery out of J2, then PE capabilities and Get
    Property Data for ResourceList, DeviceInfo and AllCtrlList; a Python
    script on the AudioFuse ports answers from hard-coded JSON, chunked to
    the initiator's 512-byte limit. The whole exchange takes 0.55-0.72 s,
    the 788-byte control list 320 ms, so CI at 31250 baud is practical.
    macOS turned out to send its own Discovery messages on the AudioFuse
    port. AllCtrlList replaces ChCtrlList (which needs a ChannelList).
    The static half of S1 is logged too: macOS 26.5 ships Network MIDI 2.0.
    .wifi (dev credentials) is gitignored.
2026-10-08 Spike S2: BLE MIDI with Wi-Fi on the C6's one radio; S3 over BLE
    A BLE MIDI <-> TRS bridge whose Wi-Fi can be off, joined, or pushing
    UDP, timed one way on the Mac through the AudioFuse. Through CoreMIDI's
    BLE driver (7.5 ms interval) BLE -> TRS is 15.7 ms median, TRS -> BLE
    9 ms, and Wi-Fi traffic raises p95 to ~40 ms with nothing lost, so
    Network mode can keep BLE on.
    tools/hil/blemidi hands a BLE MIDI device to CoreMIDI from the command
    line (bleak alone leaves macOS at a 30 ms interval); activation is
    ignored while another CoreMIDI client process is open, hence the retry
    and the "connect BLE first" rule. tools/hil/cidevices lists what
    MIDICIDeviceManager found: macOS runs MIDI-CI Discov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
2026-10-08 Spike S1: Network MIDI 2.0 host on the receiver, macOS connects
    The receiver advertises _midi2._udp over mDNS and accepts one client
    session (Invitation, Ping, Bye, Session Reset, UMP Data, UMP Endpoint
    and Function Block discovery), bridged to TRS. macOS 26.5 lists it in
    Audio MIDI Setup, connects with a MIDI 2.0 protocol session, and MIDI
    passes both ways: 6-7 ms median one way, with a p95 of 60-78 ms that a
    plain ping shows too (the Wi-Fi link). At 5 ms spacing 45/600 packets
    were lost, so the real transport needs retransmit requests and FEC.
    Decision: Network MIDI 2.0 first, RTP-MIDI later.
    tools/hil/latency.py times any wireless port against the AudioFuse.
2026-10-08 lib: UMP, MIDI 1.0 parser/encoder and M2-104 translation, with tests
    The portable core every transport will share, plain C11 with no ESP-IDF
    headers so the same files build for the host and the ESP32:
    - ump: the packet type, builders and field accessors, words per MT.
    - midi1_in: MIDI 1.0 bytes -> UMP, byte at a time, with running status,
    real-time anywhere (also inside SysEx), system common and stray F7
    cancelling running status, a status byte cutting SysEx short, and
    dropped bytes counted. SysEx is held one byte so no packet is empty.
    - midi1_out: UMP -> bytes with optional running status, closes a SysEx
    whose END was lost, translates MIDI 2.0 channel voice down.
    - translate: Min-C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
2026-10-08 firmware: ESP-IDF project for both boards, board layer, NVS settings
    firmware/ builds for the C6 and the S3 (build.sh c6|s3, one build dir
    and sdkconfig per board). components/airmidi_core compiles lib/ as is.
    The board component is the only place that names a GPIO: a Kconfig
    choice picks the pin table, and board_init() powers the C6's RF switch
    and selects the ceramic antenna. Settings rules (fields, defaults,
    validation) live in lib/ with host tests; nvs_settings stores one key
    per field plus a schema number, so an older image after an OTA rollback
    still reads what it knows. The boot log shows version (git describe),
    board, reset reason and settings. Verified on the C6 board.
2026-10-08 CI, local check script, design notes for phase 1
    GitHub Actions: host tests under ASan/UBSan, a clang-format check pinned
    to 18.1.8 (output changes between versions), and firmware builds for
    both boards with the binaries as artifacts. tools/check.sh runs the
    same locally. Design notes: core (UMP, MIDI 1.0 parser/encoder,
    translation, with the rules each test covers), board and settings, and
    testing (host, CI, the AudioFuse HIL rig). README brought up to date.
2026-10-08 lib: BLE MIDI packets, router, merge, button/LED/battery logic
    The host-testable half of phase 2:
    - blemidi: decode strips header + timestamps into plain bytes for a
    per-connection midi1_in (so running status and SysEx carry across
    packets); encode packs UMPs into packets up to the connection's MTU,
    never splitting a message (only SysEx data), and starts a new packet
    when the timestamp's high bits change so receivers rebuild time right.
    Round trips at 20, 64 and 244-byte payloads.
    - router: route matrix per (source, destination) with channel filter,
    message-class filter and channel remap; stream and utility messages
    are link-local and never routed.
    - merge: one per MIDI 1.0 out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
2026-10-08 firmware: the TRS <-> BLE MIDI bridge, passing 15/15 on the hardware
    The bus task owns routing and every output: transports only call
    bus_send(), port up/down travels through the same queue, each output
    reports room() so a burst waits in its merge queue instead of being
    dropped. uart_midi: TRS in/out with running status. ble_midi: NimBLE
    peripheral, two centrals, per-connection parser and packetizer, and a
    notification backlog that packs bursts into full packets. ui_io and
    power: button gestures (double press = all notes off), LED states,
    battery gauge with low-battery shutdown. Console 's' prints counters,
    'm' injects notes from a second port for the merge test.
    tools/hil/bridge_test.py ru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
2026-10-08 Power modes measured: frequency scaling by default, no light sleep
    A runtime switch (console 0/1/2) between fixed 160 MHz, frequency
    scaling and scaling plus automatic light sleep, and a rig test
    (tools/hil/sleep_test.py) that sends single messages after 1.5 s of
    silence both ways in each mode. Scaling loses nothing; light sleep lost
    6/15 TRS messages after idle even with the UART on the crystal, and it
    silences the C6's USB serial/JTAG until RESET. The USB meter (coarse)
    only shows light sleep as clearly lower. So the firmware boots with
    scaling; light sleep waits for a standby mode or rev B with MIDI IN on
    the LP UART pins. Readings and method in docs/measurements.md.
2026-10-08 firmware: OTA partition table, rollback self-test, core dump to flash
    Two 1.75 MB app slots, a 64 KB core dump slot and 320 KB of storage
    (the plan's layout; NVS stays at 0x9000 so settings survive the
    switch). With app rollback on, a new image boots "pending verify":
    the ota component confirms it after 10 s if the self-test passes
    (settings readable, BLE host synced, nothing dropped on the bus) and
    otherwise, or after a crash, boots the previous image. The boot log
    (and console 'i') shows the running slot, its state, a rolled-back
    slot and a core dump summary. Settings defaults are filled in before
    NVS is touched, so an NVS failure leaves a working box and a failed
    self-test. Verified on th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
2026-10-08 firmware: Wi-Fi modes (Play, Network, Setup) with mDNS and the button
    net: Play turns Wi-Fi off; Network joins the stored networks in turn
    (3 tries each, 2 s apart); Setup opens an access point named after the
    box at 192.168.4.1 (open on purpose: it exists only after an 8 s press,
    and firmware it accepts must be signed). Up to 5 networks in our own
    NVS namespace, newest first; dev builds seed the gitignored .wifi on
    first boot. mDNS announces <name>.local. A long press switches Play <->
    Network, a very long one Setup, the mode is saved; the LED shows
    joining and Setup; console P/N/S for the test scripts.
    On the rig: joins in 2 s, <name>.local resolves, the access point comes
    up, and bridge_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
2026-10-08 Web UI and JSON API, served from the firmware
    web/: plain HTML/CSS/JS in the forslike style (cascade palette, Geist
    subset to 11 KB, no borders or boxes): a status page whose hero is a
    pair of traffic meters per port in the port's hue, battery and Wi-Fi
    tiles, the mode as an option picker; settings and Wi-Fi networks as
    wide tiles you type into; an update page with the running slot, any
    rollback and crash, and an upload with progress. 18 KB gzipped, built
    into the image at compile time so UI and firmware always match.
    webui: esp_http_server with /api/status, settings (validated by the
    same settings_check the host tests cover; a new name restarts the
    box), mode, wifi (passwords never leave t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
2026-10-08 Updates from published releases; release workflow; final flash layout
    The box reads <base>/manifest.json (GitHub's releases/latest/download
    by default, overridable per request), reports whether a newer version
    exists, and on request downloads its board's image in a background
    task through the same ota_begin/write/end path as an upload, so the
    signature check, the stale-sector erase and the self-test all apply.
    The update page gains check and install with progress.
    HTTPS made the image 1.63 MB, so before anything is released (an
    update cannot move partitions) the build optimises for size, uses the
    common-CA bundle and drops unused BLE roles (1.45 MB), and storage
    gives 128 KB to the app slot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
2026-10-08 Network MIDI 2.0 host on the box; BLE off in Network mode
    net_midi: the socket, a 10 ms receive loop driving lib/nm2, mDNS
    _midi2._udp with endpoint name and product instance id, sessions as
    PORT_NET_0/1, endpoint discovery answered per session, MIDI 1.0 <-> 2.0
    translation for a client that asks for MIDI 2.0. The status API and
    the web UI show the sessions and their loss/recovery counters.
    Found on the rig:
    - macOS 26.5 never answers a host's pings and is silent while idle,
    so the first version dropped every session after 19 s. Clients are
    now never dropped for unanswered pings; a client silent for 60 s
    gives way when both slots are taken.
    - With the BLE stack running, network MIDI t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
2026-10-08 Web UI control surface over a WebSocket (phase 4 done)
    A play page with faders for common CCs (drag, double-click resets),
    one octave of pads, channel and octave steppers and a live monitor,
    in the web port's hue. It sends and receives UMP over /ws as PORT_WEB,
    so incoming CCs move the faders. tools/hil/ws_test.py: page -> TRS
    3.9 ms median, TRS -> page 10.1 ms, 100/100 each way.
    Found on the way: ESP-IDF 5.5 does not call a WebSocket URI handler
    for the handshake, so pages never became a destination until
    ws_post_handshake_cb registered them; and a scripted edit had put the
    play page's setup into the hashchange handler (blank page, caught by
    reading Chrome's console).
2026-10-08 lib: MIDI-CI initiator and responder, SysEx7 reassembly
    The box finds the device on its TRS jacks with MIDI-CI and reads its control list; this is the
    protocol half, as pure logic so it is tested on the host like the rest of lib/.
    - midici: build/parse Discovery, PE Capabilities, Get Property Data (with resId), ACK/NAK,
    Invalidate MUID.
    - midici_initiator: Discovery -> PE Capabilities -> Get ResourceList, then DeviceInfo,
    AllCtrlList and one CtrlMapList per ctrlMapId, whichever the ResourceList names. One request
    at a time; chunk order checked; ACK timeout-wait honoured; replies not addressed to it
    (macOS sends its own Discovery on hardware ports) are ignored.
    - midici_responder: th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
2026-10-08 Box asks the device on its TRS jacks with MIDI-CI, caches the answers
    PORT_CI is the initiator's own bus port and only exchanges SysEx with TRS, so its Discovery
    never leaves on BLE or the network, while the device's replies still reach every port: a
    MIDI-CI host behind the box (macOS) can talk to the device too, at no extra cost.
    The ci component reassembles SysEx from the bus, runs lib/midici_initiator in its own task,
    keeps the answers in LittleFS keyed by manufacturer/family/model/version (a known device is
    rescanned in ~40 ms instead of ~0.8 s), and stores a hand-written profile for devices without
    MIDI-CI. Scans run 2 s after boot, on a short button press, from the console (d/D) and f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
2026-10-08 Web UI: the play page draws the device's own controls
    From the AllCtrlList (MIDI-CI or an uploaded profile): faders for continuous controls,
    pickers for valueSelect controls named by their CtrlMapList (or stepCount), toggles for
    toggle/momentary, ordered by priority, priority 5 hidden. Controls send MIDI 2.0 channel
    voice with the full 32-bit value and the box scales it for the MIDI 1.0 jack; CCs coming
    back from the device move them. The generic page stays underneath.
    Also: [hidden] now wins over .glyph's display (the update page's install button showed too).
2026-10-08 Mac MIDI-CI device stand-in and the end-to-end CI test
    devices/mac_standin is lib/midici_responder on CoreMIDI, on the AudioFuse ports cabled to the
    box: a small synth's DeviceInfo, AllCtrlList and one CtrlMapList, and it prints the channel
    messages it receives. tools/hil/ci_test.py checks the whole path on the hardware: scan,
    the served JSON equals the device's, cached rescan without Property Exchange, page fader ->
    device CC at 0/64/127, profiles, and "no device" when the stand-in is gone (19/19).
2026-10-08 Web UI WebSocket: one queued send at a time, count what does not fit
    The page lost frames as soon as SysEx came in from TRS: the bus queued one async send per
    batch (a batch every ~2 ms at 31250 baud), the server's work queue is a UDP socket with a
    6-message mailbox, and a failed queue silently freed the frame. Phase 4's test sent CCs 20 ms
    apart and never got there; MIDI-CI pass-through did (3 of 6 packets of a Discovery reply).
    Now the bus only appends to a shared buffer and queues a send when none is waiting; the send
    runs in the server task and takes everything collected. Words that do not fit are counted in
    the web port's "dropped". ci_test.py gains the check that found it: a MIDI-CI h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
2026-10-08 Docs: MIDI-CI design note, phase 5 in the plan, README and measurements
    The note covers the layers, PORT_CI and pass-through, the cache, how the page maps a control
    list to controls, the measured scan times, the tests, and what the hardware found: the
    WebSocket frame loss (fixed), the ROM boot banner leaving through MIDI OUT at every reset
    (open, needs the user's decision: eFuse or a rev B pin), one unexplained missed boot scan, and
    macOS not running MIDI-CI Discovery this time.
2026-10-08 Board #1: ROM boot banner off UART0 by eFuse; resets no longer send garbage MIDI
    UART_PRINT_CONTROL = 0b11 on the C6 (the user's decision; irreversible, harmless: the USB
    console keeps the ROM log). Measured with the stand-in on MIDI OUT: hardware resets send
    nothing, software restarts only the intended all-notes-off, download mode still sends 3
    messages (the ROM's download handler, bench only). The S3 will need the same fuse.
2026-10-08 lwIP sockets 10 -> 16: one browser tab could lock the web server out
    accept() failed with ENFILE: the server's 7 connections plus its listening and control
    sockets plus Network MIDI's UDP socket already used all 10 lwIP sockets, so the server's own
    limit, and its drop-the-oldest purge, was never reached. A browser tab (keep-alive connections
    and the WebSocket) was enough. Checked: 12 held keep-alive connections, fresh requests 5/5.
2026-10-08 nm2: take back a session the client still believes in after a restart
    macOS never invites a host again once a session has ended, however it ended: a Bye from the
    host (the spec's answer, 0x05, to data from a client without a session), or its own ping
    timeout. Either way it drops the host from its list and the user reconnects by hand after
    every power cycle, update or crash. The rebooted host answering pings was no better: macOS then
    believed in a session the host no longer had.
    Now a client that pings or sends data without a session is taken back: Session Reset, both
    sides number from 0 on the reply, no data goes out meanwhile, only the newest command of the
    triggering datagram is delivered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
2026-10-08 lib: UMP endpoint announcement, MIDI-CI in the function block, nm2 knows when a client has spoken
    macOS never sends Endpoint or Function Block Discovery over a Network MIDI 2.0 session, so the
    box has to say who it is. ump_endpoint_announce() is the reply to a full Endpoint Discovery,
    sent unasked. The function block now declares MIDI-CI (message version 2): the TRS device's
    MIDI-CI passes through it. nm2's 'heard' tells when the client has sent something since the
    session started, i.e. its side is up.
2026-10-08 net_midi: announce the endpoint once the client has spoken on a new session
    Told, macOS asks for the function block, switches the session to MIDI 2.0 and runs MIDI-CI
    Discovery through the box, so MIDICIDeviceManager finds the synth on TRS. Sent right behind
    Invitation Accepted, the announcement made macOS answer Bye 0x05 in 1 of 4 connects; after the
    client's first packet (macOS pings at once), 8 of 8. A resumed session waits for its Session
    Reset to be answered, as all its data does.
2026-10-08 Guard MIDI 1.0 outputs against MIDI-CI Discovery loops
    macOS passes a Discovery arriving on one MIDI port on to its other MIDI-CI endpoints. With the
    box's TRS cabled back to the same Mac, the box's own Discovery circled Mac -> network -> box ->
    TRS until the line was full and scans timed out. A Discovery from another port within a second
    of the last one written to the output is now dropped whole; the box's own initiator always
    passes. Loops die on their first lap.
2026-10-08 Docs: why macOS found no MIDI-CI device, the announcement, Discovery loops, MIDI 2.0 latency
2026-10-09 lib/rtpmidi: what macOS's driver needs, and taking a session back after a restart
    Found against macOS 26's RTP-MIDI driver (tools/hil/rtp_test.py):
    - M bit 0. RFC 6295 says 1 when the packet carries MIDI; macOS then held every
    packet back ~25 ms and dropped some. Apple's own packets have it 0; with 0,
    4-6 ms and nothing lost.
    - macOS keeps clock-syncing a box that restarted and ends the session after
    three unanswered syncs, and does not invite it again. A clock sync or MIDI
    from a client without a session now takes the session back (needs an SSRC
    that survives the restart, from the caller).
    - The taken-back stream must continue the old sequence numbers (macOS drops
    packets it tak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
2026-10-09 BLE central: the box connects by itself to a BLE MIDI keyboard or controller
    PORT_BLE_CENTRAL, a third NimBLE connection next to the two centrals that may
    connect to the box. Setting ble_device (schema 3): none, "*" (the first BLE MIDI
    device found), a name, or an address (macOS's own peripheral advertises no name).
    The box scans a third of the time until it finds it, connects at 7.5-15 ms, finds
    the MIDI characteristic, subscribes and exchanges the MTU; devices that want
    pairing get "just works" with a bond in NVS. Connection update requests are kept
    within 15 ms. The web page lists the BLE MIDI devices around (/api/ble) and sets
    the device without a restart.
    tools/hil/blepeer is a CoreBlu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
2026-10-09 lib/usbmidi: USB MIDI 1.0 event packets to and from UMP
    Packets of 4 bytes: cable and Code Index Number, then up to 3 MIDI bytes; SysEx 3
    bytes a packet, the last saying how many bytes end it. Receiving gives a packet's
    bytes for a midi1_in parser; sending turns UMP into packets (MIDI 2.0 translated
    down as for TRS, real-time in its own packet even inside a SysEx). USB MIDI 2.0 is
    not offered: every host speaks 1.0, and the box's MIDI-CI passes through either way.
    Tests: every CIN, SysEx of every length up to 40 with a clock inside through a parser
    and back, an unfinished SysEx ended by the next message, MIDI 2.0 translation.
2026-10-09 Board: the ESP32-S3-DevKitC-1 on its own (build.sh s3kit)
    A second box for USB MIDI and ESP-NOW without a second receiver PCB: no LED, no
    battery (always on USB), BOOT as the button, MIDI UART on GPIO17/18 if wired. Its
    USB-UART port carries the boot log and panic reports, and flashes with auto-reset.
    build.sh flash on an S3 running TinyUSB first restarts it into the ROM bootloader
    through its serial port (esptool's reset pattern), then flashes the USB-Serial-JTAG
    port that comes up, and starts the app with a watchdog reset: macOS holds DTR (=
    GPIO0 low) through esptool's RTS reset, so the chip came back in download mode.
    check.sh builds it too.
2026-10-09 USB MIDI on the S3 (TinyUSB): a class-compliant MIDI device, the console beside it
    PORT_USB, a MIDI 1.0 byte output (the bus merges its sources), named after the box
    so the Mac lists it as such. TinyUSB takes the S3's only USB PHY from USB-Serial-
    JTAG, so the console moves to a CDC serial port on the same device, with esptool's
    reset pattern (and console 'B') restarting into the ROM bootloader.
    Found on the dev kit: the PHY selection survives a restart, and the next boot hung
    writing to an unreachable USB-Serial-JTAG; a shutdown handler hands the PHY back
    first, and the S3's console is no longer USB-Serial-JTAG at all (a panic report
    hung there too, before the core dump was written). A UAR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
2026-10-09 Wi-Fi: a bigger event task stack, and the reason a join failed in the log
    The default event loop's 2.3 KB stack overflowed the first time an S3 joined Wi-Fi
    (Xtensa frames are bigger than the C6's RISC-V ones): 4 KB now.
2026-10-09 lib/espnow_link: the ESP-NOW cable between boxes, and its settings
    Boxes in the same group find each other by a hello broadcast once a second, then
    pass UMP to each other by unicast (ESP-NOW acknowledges and retries at the radio).
    The receiver drops the duplicates those retries make and counts losses, from the
    first frame on (hellos carry the next sequence number).
    Both boxes must share a channel: one joined to an access point stays on its
    channel; a free one goes looking, back to channel 1 every other step (two free
    boxes meet there) and to 6, 11 and the rest in between, each at its own pace.
    Settings schema 4: espnow (off by default: in Play mode it keeps the radio on) and
    espnow_group.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
2026-10-09 Console: output resumes after TinyUSB's serial port dropped some
    TinyUSB's console does not block: with nobody reading, a write comes back short,
    and the C library leaves stdout in its error state for good. The S3 ran on but
    never printed again, which looked like a hang. The main loop clears the error.
2026-10-09 ESP-NOW cable on the box (espnow_midi), and a Wi-Fi power limit per board
    PORT_ESPNOW, UMP straight through (the boxes translate at their own MIDI 1.0
    outputs). With ESP-NOW on, Play mode keeps the Wi-Fi radio on without joining;
    Network mode tells the link the access point's channel. Web page: the toggle and
    the group, and who was found; console 'E' toggles it on boxes without a web page.
    Found on the dev kit: at the full 20 dBm none of its Wi-Fi frames arrived (no
    ESP-NOW acknowledgement, no access point answering its authentication) while
    its BLE worked; at 10 and 15 dBm all did, most likely its 3.3 V sagging at the
    transmit peaks on USB. Boards now carry a Wi-Fi power limit (the kit: 15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
2026-10-09 Docs: phase 6 (RTP-MIDI, BLE central, OTA over BLE, USB MIDI, ESP-NOW, the dev kit)
    A design note for RTP-MIDI (the journal, and what macOS needed), the other
    transports in transports.md, OTA over BLE in ota.md, the dev kit, the Wi-Fi power
    limit and settings schemas 3-4 in board-and-settings.md, the new tools in
    testing.md, the numbers in measurements.md, phase 6 in the plan's decision log,
    and the README. CI builds the dev kit too.
2026-10-10 Releases: an image per board, so the S3 dev kit never fetches the XIAO S3's
    ota.c picked the manifest entry by chip, so a dev kit would have installed the XIAO S3 image (other MIDI pins, no
    Wi-Fi power limit). The key is now the board, with build.sh's names, and the release workflow builds s3kit too.
2026-10-10 README for a portfolio reader: photos of the box and the PCB, highlights, hardware, test table, design note index
    Photos scaled to 1600 px with their EXIF (including GPS) removed.
2026-10-10 hardware/: the receiver's rev B, exported from the design workspace (CERN-OHL-P-2.0)
    Schematic and board PDFs, renders, the KiCad project with the libraries it needs bundled (opens on its own: ERC 0,
    DRC 0, parity 0 from a copy elsewhere), Gerbers, BOM, the enclosure as STL/STEP, and a README with the circuit,
    rev A's bring-up measurements and errata. LCSC 3D models are left out (terms unclear).
2026-10-25 Merge: the latest pitch bend, pressure or controller value replaces a queued one, so floods never drop note offs
    A source can send faster than TRS carries (~1000 messages/s): the app's strips flooded the TRS output with 6 360
    messages in 5 s, the 64-entry merge queue dropped 3 207 of them, note offs included, and notes hung. A new value
    now replaces the one still queued for the same channel (and note or controller) from the same source, unless
    another message for that channel lies between them. Bank select, RPN/NRPN and channel mode controllers keep every
    message. Counted per port as `coalesced` (console, /api/status). test_merge: five new cases, including 3 000
    bends then a note off that ar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
2026-10-25 BLE: ask centrals for 7.5-15 ms first, Apple's 11.25-26.25 ms only when that is refused
    Android takes the slow end of the range it is offered: with only the Apple-compliant range a Pixel 9a settled at
    26.25 ms, a pitch bend every 26 ms. Apple's accessory rules reject 7.5-15 ms, which now triggers the second
    request (and macOS's MIDI driver sets 7.5 ms itself anyway). The Pixel now runs at 15 ms.
2026-10-25 devices/daisy_synth: an 8-voice synth on the Seed3 desktop kit that answers MIDI-CI, with an MPE mode
    The demo device behind the box's TRS jacks: two-oscillator subtractive voices, filter, glide, vibrato, chorus,
    echo and reverb, the kit's pots and switches on the parameters, and lib/midici_responder on the DIN jacks so the
    box's page draws its controls. The 1 kHz block-rate whine is held off with a steady load (README "Noise").
    MPE, for the app's pedal steel strips: the MPE Configuration Message turns on a lower zone, each member channel
    then has its own voice and pitch bend (±48 semitones, or what RPN 0 says), the manager's bend moves every voice,
    bends are smoothed over ~3 ms. The same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
2026-10-25 app/: Android app, spike A0, the pedal steel strips sending MPE to the box over BLE MIDI or its WebSocket
    Plan in docs/app.md (Flutter; setup and config over BLE come in A1). The strips are a port of the prototype's
    logic and tests (modeling/proto/pedal_steel). Strip n plays on member channel 2 + n; note messages queue in order,
    bends coalesce to the newest per channel, batches go out at least 8 ms apart so three strips stay inside what TRS
    carries, the zone setup repeats every 3 s while nothing sounds. BLE through universal_ble (BSD-3):
    flutter_blue_plus moved to a license that charges for-profit use and pings at build time. Built against Java 21
    with Gradle 8.11 / AGP 8.7 / Kotlin 2.1, sig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
2026-10-25 Settings and Wi-Fi setup over BLE: one JSON API for HTTP and BLE, trusted phones, Wi-Fi scan and try in Play mode
    So the phone app can set the box up in Play mode, without joining its access point:
    - components/api: the JSON handlers moved out of the web server; api_call(method, path, body) answers the web
    page (/api/* in webui) and the BLE config service alike. A reply can carry work for after it has gone out (a
    mode switch). web_test.py passes against it over HTTP (14/14).
    - components/ble_config + lib/blecfg.c: a GATT service carrying the API, messages split into MTU-sized pieces (id +
    LAST flag), answered on a worker task so BLE MIDI keeps moving. Needs an encrypted link and a trus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
2026-10-25 daisy_synth: restart MIDI IN after a UART error instead of going deaf until a power cycle
    With the box reset during a session (flashing, opening its console) the kit stopped hearing MIDI while the audio
    went on: USART1 showed overrun + noise flags with its DMA request off, after 7540 bytes. On an overrun the HAL aborts
    the DMA stream and tells libDaisy only when the abort completes, which never happened, so libDaisy kept saying it
    was listening. The main loop now checks the DMA request bit and stops/starts listening when it is off (tries 2 ms
    apart, as the start is refused while the aborted stream is busy). Forced three overruns over SWD: one restart each,
    notes play right after.
2026-10-25 daisy_synth: set the UART up again before listening, so MIDI IN also recovers when the HAL stays busy
    After a framing error the DMA request was already off while the HAL's receive state stayed busy; HAL_UART_DMAStop
    only resets that state while the request bit is set, so every new start was refused and MIDI IN stayed deaf (seen
    after ten good recoveries during box restarts). KeepListening now re-runs uart.Init before DmaListenStart. Checked
    over SWD: the stuck-busy case (request bit cleared, line idle) and the overrun case both recover with one restart.
2026-10-25 app: following the box works across mode changes and restarting settings; HTTP bodies with Content-Length
    Tried on the Pixel: Wi-Fi -> Setup (follows onto BLE, the phone trusted again), Play in place, Network (follows onto
    Wi-Fi), Play (follows back onto BLE), and a SysEx timeout change that restarts the box (follows, value kept).
    Fixes found doing so:
    - Dart sent request bodies chunked, which the box's server resets: every POST over Wi-Fi failed.
    - A BLE sighting from before the restart sent the follow to a box going down: only sightings after the link died
    count, and opening is retried until the box answers.
    - The replaced page's dispose disconnected the BLE device id the new page had ju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
2026-10-25 app: strips bar (box, synth, layout), synth page built from the device's MIDI-CI control list
    The strips screen gets a bar of three buttons: back to the box screen, the synth page, the layout panel; the link
    numbers move behind a "link stats" switch in the layout panel. The synth page reads /api/ci/device (the control
    list the box read from the device over TRS, or a profile) and draws faders, pickers over named values and toggles,
    with the web page's rules (lib/synth/controls.dart, tested against daisy_synth's resources). Moving a control
    sends its CC (newest value per control every 15 ms); the links now receive too (BLE MIDI notifications, the
    WebSocket's UMP), so the synth's own knobs move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
2026-10-25 app: the synth page's values live with the box screen, so reopening the page shows what was set
    Reported: set Attack, go back, play (sounds right), open the synth page again: Attack back at its default in the
    page. The page read the control list afresh each time. SynthState (owned by the box screen) now keeps the device and
    its values, follows the device's CCs while the page is closed (the strips page attaches its link), and a rescan
    keeps the values of controls still listed. Tests: set + reopen, rescan, CCs with no page open. Also fader labels
    centred and picker cells as wide as their labels. Tried on the Pixel: Attack 20 ms survives leaving and reopening.
2026-10-25 daisy_synth: time the panel scan in raw timer ticks; GetUs() wraps at 21.5 s, and the knobs stopped there
    System::GetUs() is TIM2's 200 MHz tick count divided by 200, so it wraps at 2^32 / 200 us = 21.47 s, not at 2^32.
    The last scan before a wrap scheduled the next one past the wrap point, a time GetUs() never reaches: knobs, toggles
    and keys stopped 21 s after power-up (seen: the smoothed pot values bit-for-bit frozen for 16 minutes, the CPU load
    too). The scan and KeepListening's retry spacing now use System::GetTick(), which wraps at 2^32. Checked over SWD
    past two wraps: the scan keeps running.
2026-10-25 MIDI-CI MIDI Message Report: the device reports where its knobs are, not just the control list's defaults
    MIDI-CI 1.2 Process Inquiry (M2-101 9): the initiator asks, the device answers with a Reply, its current values as
    ordinary MIDI messages, and an End. lib/midici builds and parses the messages; the responder offers it when the
    device gives a report function (and says so in its Discovery Reply); the initiator asks after a scan if the device
    said it can, and follows Reply/End, a NAK or a timeout. The box exposes it as POST /api/ci/report; the values reach
    the web page and phones like the device's own knob moves. daisy_synth reports channel 1's pitch bend and every
    parameter's CC in ascendi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
2026-10-25 app: the synth page asks for the synth's current values (MIDI-CI MIDI Message Report) when it opens
    They arrive as CCs on the link and land in SynthState like the synth's knob moves; the page says when a synth does
    not report (values then start at its defaults). Tried on the Pixel: Attack set to 20 ms, app killed and reopened,
    the page showed 20 ms.
2026-10-26 app: move mode on the strips (drag up the neck, pinch rows and width)
    A move button in the strips bar turns touches into a pan and pinch of
    the view instead of notes. Dragging moves every strip up or down the
    neck and settles on whole semitones when the fingers lift; a vertical
    pinch sets the row height and a horizontal one the strip width, both
    around the fingers. Strips wider than the screen scroll sideways and
    are clipped at the marker column; a touch past the edge plays the
    strip at the edge, never a hidden one. Fret marks repeat every 12
    frets so they follow the view.
    Defaults change to 6 strips in guitar tuning, no gap, and a width
    that fits the screen ("fit" in the layout panel retur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
2026-10-26 app: strips snap to whole strips on "done"; press bar inside the note; no fret markers
    Leaving move mode picks the strip count nearest to what is on screen
    and sets the width so exactly that many fill it (all of them = fit),
    with the scroll on a strip edge, so no unusable slivers are left at
    the sides. A single strip never goes past the 40 mm width limit.
    A press no longer fills the strip from the top down to the finger,
    which hid the notes above. The pressed note's row lights up, a line
    marks its centre, and a bar runs from there to the finger: how far
    from in tune shows at a glance.
    The fret marker column is gone; the strips take the whole width.
2026-10-26 app: play a computer or any MIDI device directly, over BLE or USB
    What is not an airmidi box now goes through Android's MIDI service
    (a small Kotlin bridge in MainActivity, lib/link/android_midi.dart)
    instead of the BLE plugin, and straight to the strips: there is no box
    API behind a Mac.
    - BLE: Android's own BLE MIDI driver asks for the fast connection
    interval and the big MTU. With the phone as the central that matters,
    and universal_ble has no way to ask.
    - USB: with the phone's USB mode on MIDI, its peripheral port is listed
    and the Mac sees a USB MIDI device. Tried end to end: the Mac logged
    the MPE setup, the note with its bend first, the slide and the note
    off.
    Links to a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
2026-10-26 daisy_synth 0.2: a filter envelope of its own; app: XY pad for cutoff + resonance, wave icons, graphics on/off
2026-10-27 app: keys and drum pads on the phone, one play page per link that switches surfaces
2026-10-27 desktop: MIDI router (routes in the engine: channel filter and remap, transpose, note range, types; grid page; saved)
2026-10-27 desktop: play view, the synth's controls in columns over the keys, wheels and pads (SynthControls shared with the phone's synth page)
2026-10-27 docs/daw.md: the user's decisions (every clip its own, both kinds on any track, bottom panel, fresh MPE channels, p-locks later)
2026-10-27 desktop: DAW A2, the piano roll edits (draw, select, move, copy, resize, quantize, legato, transpose, velocity lane, audition); replace recording; drive drag/rtap/more keys
2026-10-27 desktop: DAW A3, the sequencer (paint/erase/velocity drag, per-step lane for velocity/gate/probability/nudge/repeat, row sets and row menu, double, rotate, pages, to MIDI clip)
2026-10-27 desktop: DAW A5, controllers (MIDI-CI lists per track, named lanes with ramps, MPE note expression lanes, chase, device tab); menu chips open again
2026-10-27 desktop: DAW A6, hardware (program and bank per track, synth settings kept with the project and read from the synth through the box, click and count-in, latency per port, parameter locks); drive tool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
2026-10-31 firmware: rev B panel (build.sh s3b): a button per mode with an LED over each (BLE, NET, STP, PWR), holds for pairing, update check, MIDI-CI scan and power off, fast double-tap panic, battery bar, PW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
2026-11-05 firmware: rev C board (build.sh s3c): SMT main board with no PSRAM, per-LED panel_led_max for rev B and rev C, jack detect, VBUS sense for the self-powered USB port, OTA key s3c
